youssefAchrf/Autonomous_Robot/README.md

# Autonomous_car
we introduce the implementation of a price-guide robot using machine vision
and sensors to ease the process of price guides. The robot will replace the current 
screens. The robot will follow black lines wherever they go, and provide information
about the item once the clients have given it the command to do so. The robot detects 
moving bodies, thus providing information about items, using bar code. 

Autonomous Robot that utilise vision and navigation systems to help costumers get familiar with the scenes, the robot utilises Line follower algorithms , bar-code and faces vision , ROS communication protocols , Raspberry and Arduino MEGA Micro controllers, OpenCV vision
