youssefAchrf/Autonomous_Robot/poster.pdf

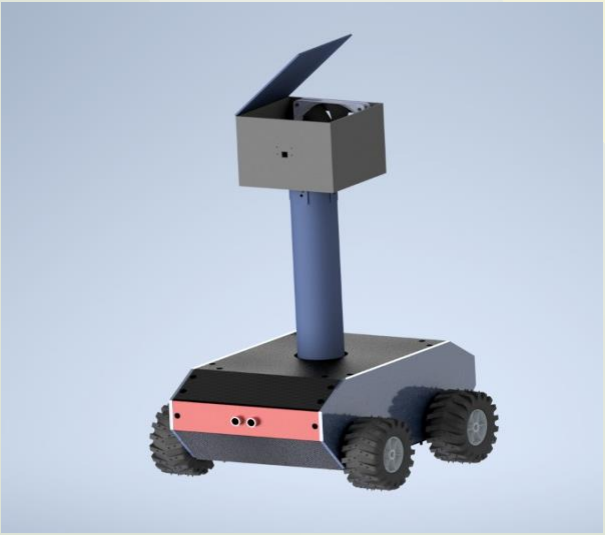
[picture p26: figure]
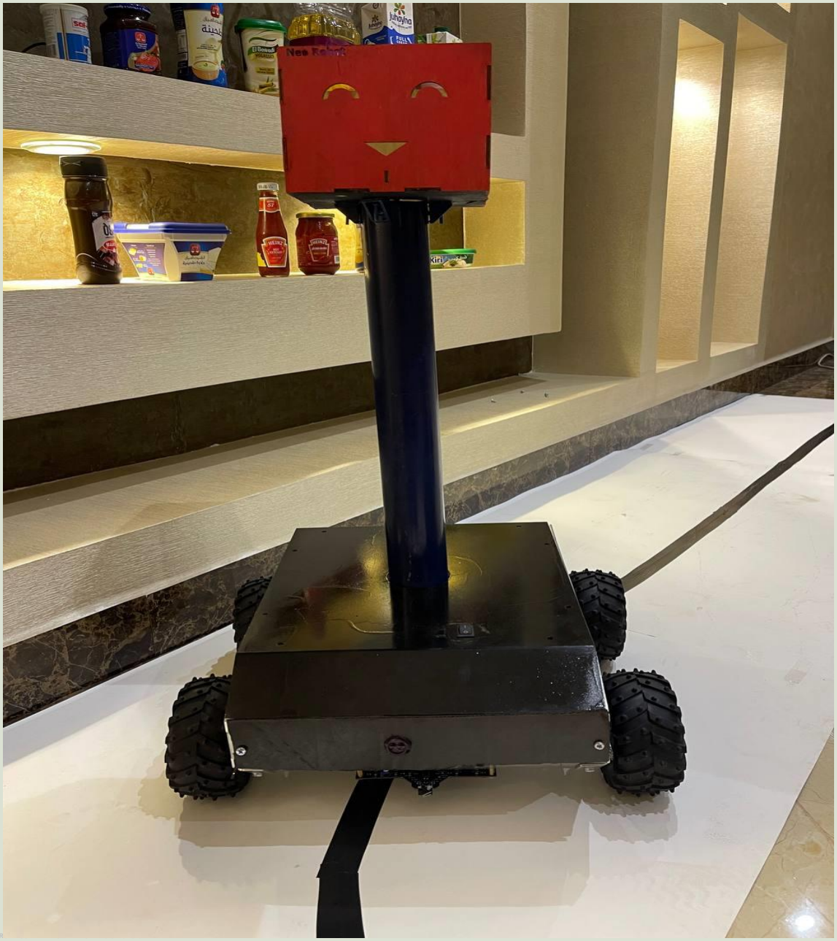
[picture p27: figure]

RESEARCH POSTER PRESENTATION DESIGN © 2012
www.PosterPresentations.com

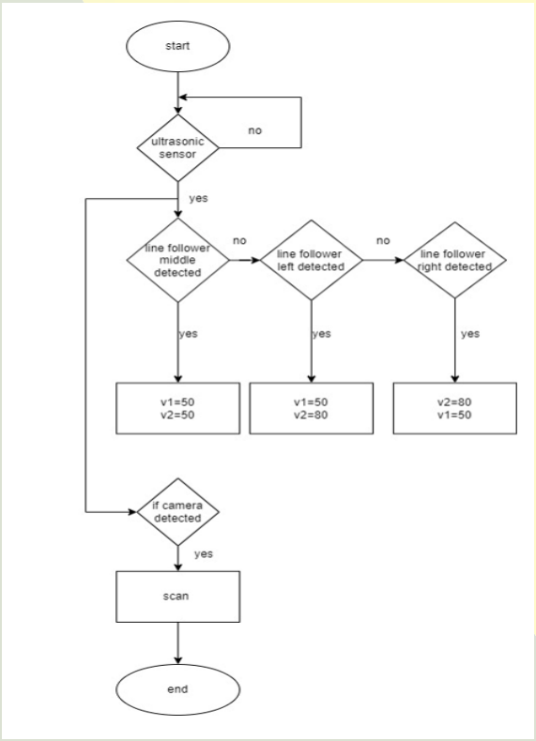
[picture p28: figure]

RESEARCH POSTER PRESENTATION DESIGN © 2019
www.PosterPresentations.com

RESEARCH POSTER PRESENTATION DESIGN © 2019
www.PosterPresentations.com

Supermarket numbers are countless all over the world. However, going to a supermarket without knowing the price of each item would feel curious and confused. In this work, we introduce the implementation of a priceguide robot using machine vision and sensors to ease the process of price guides. The robot will replace the current screens. The robot will follow black lines wherever they go, and provide information about the item once the clients have given it the command to do so. The robot detects moving bodies, thus providing information about items, using bar code.

Why you should get our Neo Robot?

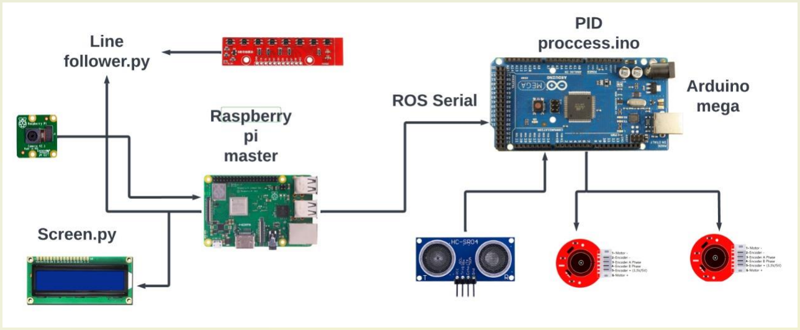
[picture p29: figure]

Wire drawings

communiation

## Neo Robot

# Price Guide Robot

Robot design

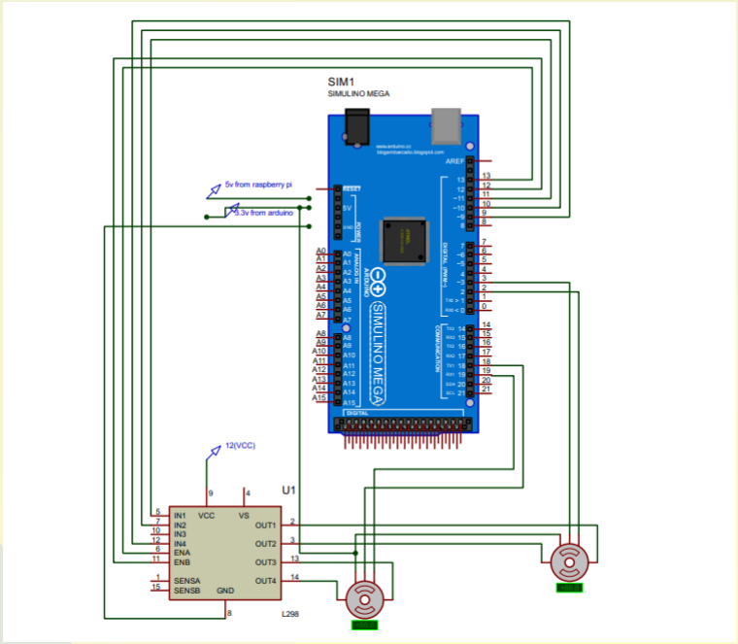
[picture p30: figure]

Flow chart

Real Robot
